AntoninLize/Projet_OrangeLabs/README.md

# Projet_OrangeLabs

Etudiants travaillant sur ce projet :

   * Antonin Lizé
   * Ludovic Diguet

Collaboration avec :

   * Jacques Chodorowski travaillant à OrangeLabs à Lannion (Finistère)
