AntoninLize/Projet_OrangeLabs/Code/Workspace_Realsens_RPLidar/README.md

# Ces programmes ne sont exécutables que dans un Workspace prédéfini

**Pour l'utilisation :**

````
Installation des SDK décrits dans le rapport, intaller les package ROS pour le fonctionnement des composants.

````

````
Les packages sont déja installés et prêt à utilisation sur le NUC

````

````
Dans le dossier source :
 - Le pacckage pour la caméra Realsense  : realsense-ros
 - Le package pour le rplidar : rplidar_ros

````

````
Les commandes à utiliser pour le lancement sont :
Pour la caméra : roslaunch realsense2-camera rs-camera.launch
Pour le rplidar : roslaunch rplidar_ros rplidar.launch

````
