AntoninLize/Projet_OrangeLabs/Code/Arduino/README.md

#Installation de la librairie DualVNH5019MotorShield

**Consignes :**

````
Il suffit d'ouvrir Arduino, d'aller dans l'onglet "Croquis". 

````

````
Cliquez sur "Inclure une Bibliothèque" -> Gérer les bibliothèques

````

````
Dans la fenêtre Gestionnaire de bibliothèque "Filtrez la recherche" en tapant le nom de la bibliothéque.

````

````
Mettez ensuite installer et l'inclusion se fait immédiatement par #include "DualVNH5019MotorShield.h"
en tête du code Arduino

````
