AntoninLize/Projet_OrangeLabs/Rapport/images/station de recharge/Archi 1.png

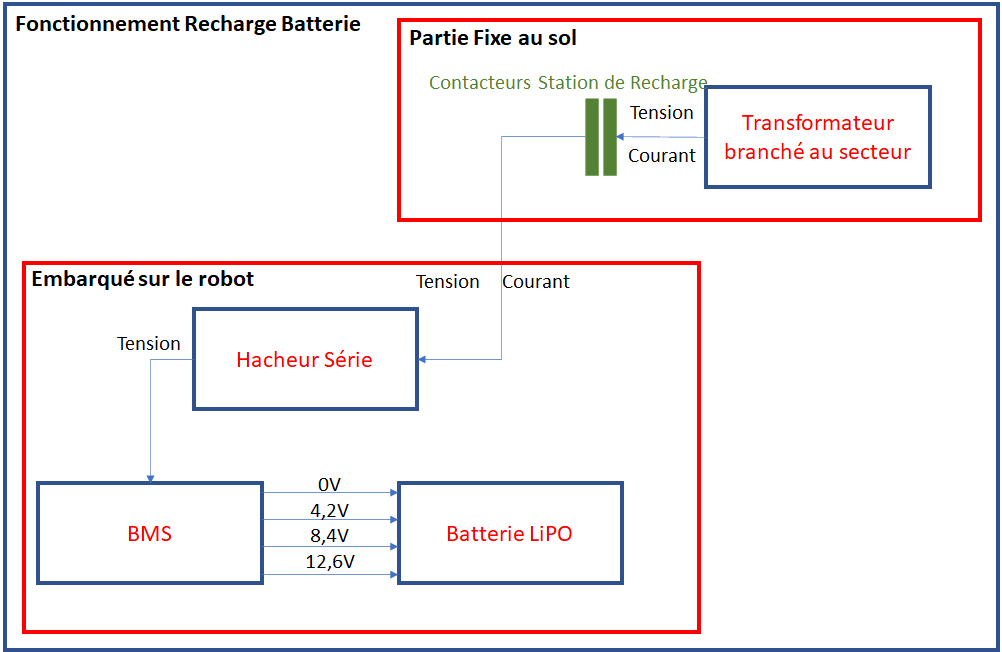
Rapport/images/station de recharge/Archi 1.png
