AntoninLize/Projet_OrangeLabs/CAO/Robot/Support batterie/Couvercle_support_batterie.stl

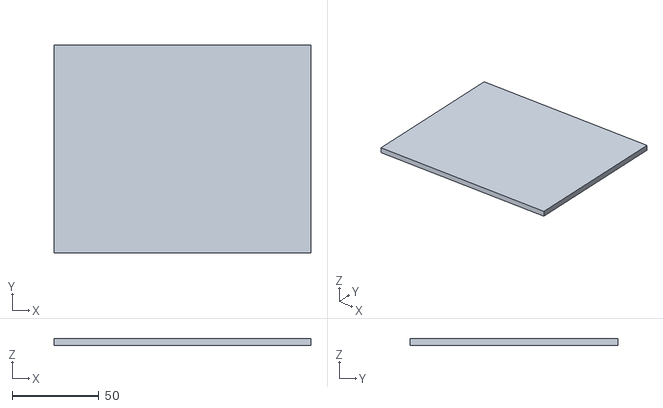
[picture p35: CAD file, 2020-05-09]
CAO/Robot/Support batterie/Couvercle_support_batterie.stl
148.0 x 120.0 x 4.00
