AntoninLize/Projet_OrangeLabs/CAO/Station de recharge/pièce_fixe_station.stl

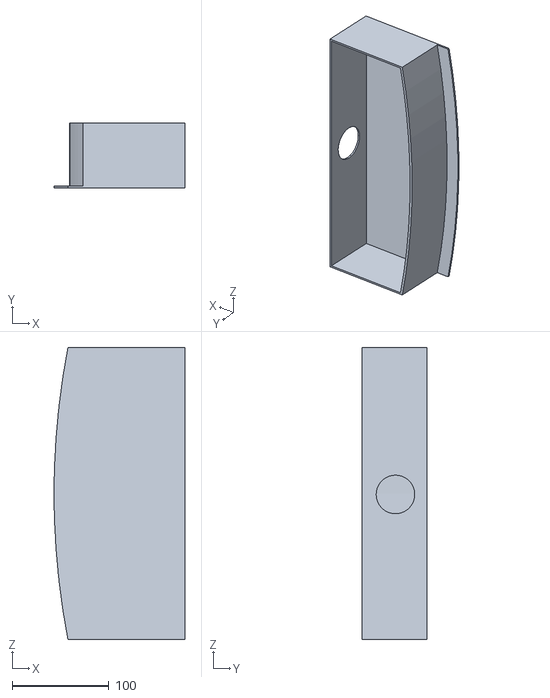
[picture p36: CAD file, 2020-05-09]
CAO/Station de recharge/pièce_fixe_station.stl
135.0 x 67.0 x 301.2
