AntoninLize/Projet_OrangeLabs/CAO/Station de recharge/usinage/pièce centrale.stl

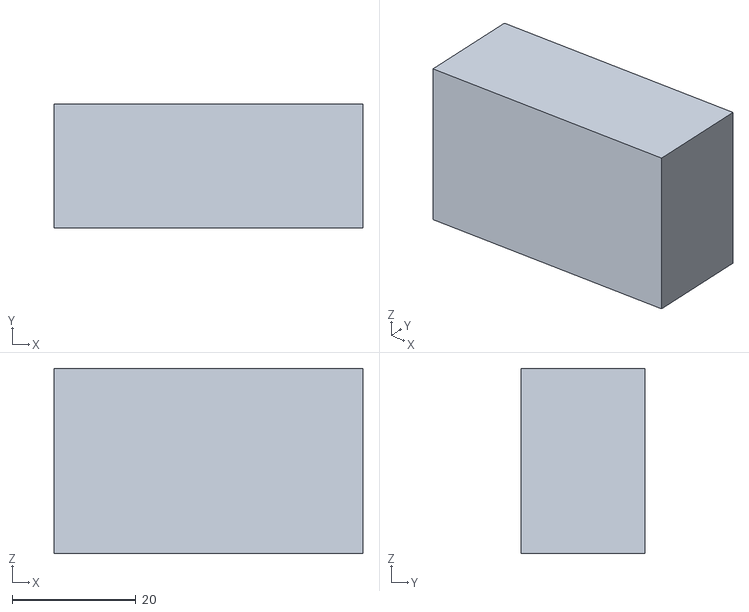
[picture p37: CAD file, 2020-05-09]
CAO/Station de recharge/usinage/pièce centrale.stl
50.0 x 20.0 x 30.0
