AntoninLize/Projet_OrangeLabs/CAO/Robot/Support batterie/Support_batterie.stl

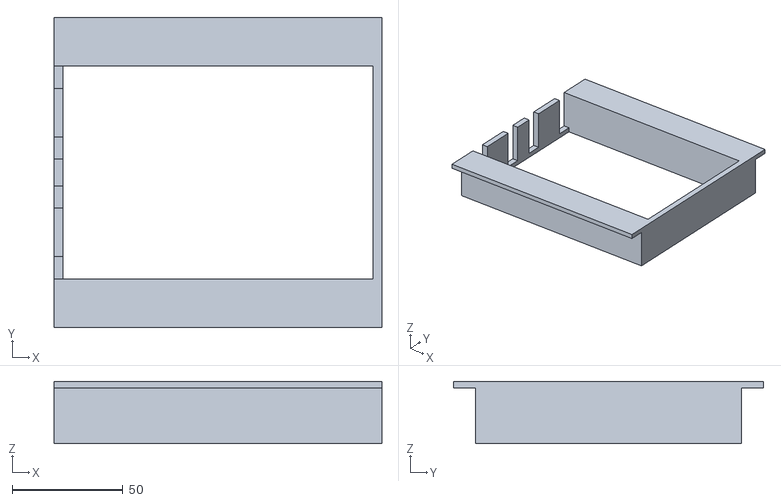
[picture p38: CAD file, 2020-05-09]
CAO/Robot/Support batterie/Support_batterie.stl
148.0 x 140.0 x 28.0
