AntoninLize/Projet_OrangeLabs/CAO/Station de recharge/pièce_mobile_station.stl

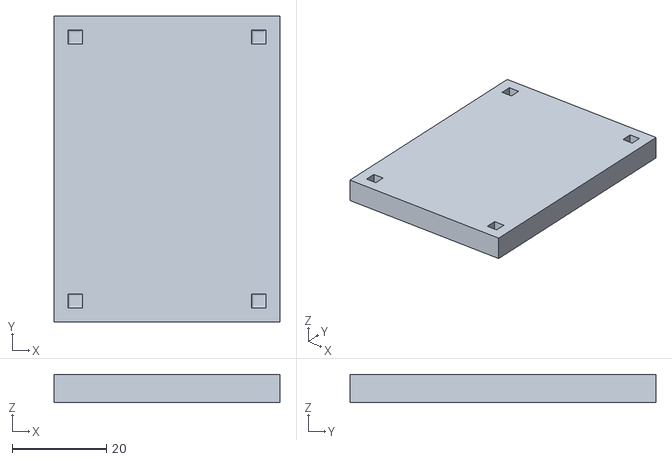
[picture p39: CAD file, 2020-05-09]
CAO/Station de recharge/pièce_mobile_station.stl
48.0 x 65.0 x 6.00
