AntoninLize/Projet_OrangeLabs/CAO/Station de recharge/usinage/pièce_x2.stl

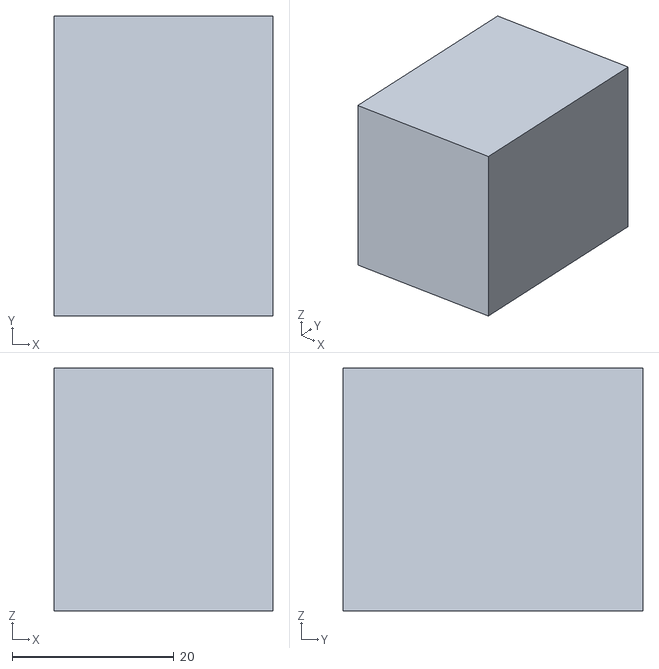
[picture p40: CAD file, 2020-05-09]
CAO/Station de recharge/usinage/pièce_x2.stl
27.0 x 37.0 x 30.0
