AntoninLize/Projet_OrangeLabs/(list of files, cad)

Other CAD files:
CAO/Robot/Chassis/Adaptateur_axes_C.ipt
CAO/Robot/Chassis/Adaptateur_axes_MT.ipt
CAO/Robot/Chassis/Assemblage_chassis_14_11_C.iam
CAO/Robot/Chassis/Assemblage_chassis_14_11_MT.iam
CAO/Robot/Chassis/Chassis.ipt
CAO/Robot/Chassis/Entretoises 50mm.ipt
CAO/Robot/Chassis/Entretoises 80mm.ipt
CAO/Robot/Chassis/Etage 1.ipt
CAO/Robot/Chassis/Etage 2.ipt
CAO/Robot/Chassis/Moteur.ipt
CAO/Robot/Chassis/Moteur_C.ipt
CAO/Robot/Chassis/Moteur_MT.ipt
CAO/Robot/Chassis/OldVersions/Assemblage_chassis_14_11.0005.iam
CAO/Robot/Chassis/OldVersions/Roue_moteur_C.0002.iam
CAO/Robot/Chassis/OldVersions/Roue_moteur_MT.0003.iam
CAO/Robot/Chassis/Roue.ipt
CAO/Robot/Chassis/Roue_Crawler.ipt
CAO/Robot/Chassis/Roue_MonsterTruck.ipt
CAO/Robot/Chassis/Roue_moteur_C.iam
CAO/Robot/Chassis/Roue_moteur_MT.iam
CAO/Robot/Chassis/Support_moteur_C.ipt
CAO/Robot/Chassis/Support_moteur_MT.ipt
CAO/Robot/Etage/Etage.ipt
CAO/Robot/Etage/OldVersions/Etage.0004.ipt
CAO/Robot/Etage/entretoise.ipt
CAO/Robot/Support batterie/Couvercle_support_batterie.ipt
CAO/Robot/Support batterie/OldVersions/Couvercle_support_batterie.0002.ipt
CAO/Robot/Support batterie/OldVersions/Support_batterie.0004.ipt
CAO/Robot/Support batterie/Support_batterie.ipt
CAO/Station de recharge/OldVersions/arc n°1.0004.ipt
CAO/Station de recharge/OldVersions/arc n°2.0004.ipt
CAO/Station de recharge/OldVersions/arc n°3.0003.ipt
CAO/Station de recharge/OldVersions/arc n°4.0003.ipt
CAO/Station de recharge/OldVersions/arc n°5.0002.ipt
CAO/Station de recharge/OldVersions/arc n°6.0001.ipt
CAO/Station de recharge/OldVersions/arc_de_cercle.0002.ipt
CAO/Station de recharge/OldVersions/bloc station.0001.ipt
CAO/Station de recharge/OldVersions/contacteur.0004.ipt
CAO/Station de recharge/OldVersions/couvercle_contacteur.0004.ipt
CAO/Station de recharge/OldVersions/pièce_chassis.0001.ipt
CAO/Station de recharge/OldVersions/pièce_fixe_station.0004.ipt
CAO/Station de recharge/OldVersions/pièce_mobile_station.0006.ipt
CAO/Station de recharge/OldVersions/socle chassis_ressort.0003.ipt
CAO/Station de recharge/OldVersions/visualisation.0002.ipt
CAO/Station de recharge/bloc station.ipt
CAO/Station de recharge/pièce_chassis.ipt
CAO/Station de recharge/pièce_fixe_station.ipt
CAO/Station de recharge/pièce_mobile_station.ipt
CAO/Station de recharge/socle chassis_ressort.ipt
CAO/Station de recharge/usinage/pièce centrale.ipt
CAO/Station de recharge/usinage/pièce1.ipt
CAO/Station de recharge/usinage/pièce_x2.ipt
CAO/Station de recharge/visualisation.ipt
