AntoninLize/Projet_OrangeLabs/Code/Workspace_Realsens_RPLidar/build/install_manifest.txt

/home/orange/catkin_ws/install/_setup_util.py
/home/orange/catkin_ws/install/env.sh
/home/orange/catkin_ws/install/setup.bash
/home/orange/catkin_ws/install/local_setup.bash
/home/orange/catkin_ws/install/setup.sh
/home/orange/catkin_ws/install/local_setup.sh
/home/orange/catkin_ws/install/setup.zsh
/home/orange/catkin_ws/install/local_setup.zsh
/home/orange/catkin_ws/install/.rosinstall
/home/orange/catkin_ws/install/lib/pkgconfig/realsense2_description.pc
/home/orange/catkin_ws/install/share/realsense2_description/cmake/realsense2_descriptionConfig.cmake
/home/orange/catkin_ws/install/share/realsense2_description/cmake/realsense2_descriptionConfig-version.cmake
/home/orange/catkin_ws/install/share/realsense2_description/package.xml
/home/orange/catkin_ws/install/share/realsense2_description/launch/view_multiple_d435_models.launch
/home/orange/catkin_ws/install/share/realsense2_description/launch/view_d415_model.launch
/home/orange/catkin_ws/install/share/realsense2_description/launch/view_r410_model.launch
/home/orange/catkin_ws/install/share/realsense2_description/launch/view_d435_model.launch
/home/orange/catkin_ws/install/share/realsense2_description/launch/view_r430_model.launch
/home/orange/catkin_ws/install/share/realsense2_description/meshes/d415.stl
/home/orange/catkin_ws/install/share/realsense2_description/meshes/d435.dae
/home/orange/catkin_ws/install/share/realsense2_description/rviz/urdf.rviz
/home/orange/catkin_ws/install/share/realsense2_description/urdf/_d435.urdf.xacro
/home/orange/catkin_ws/install/share/realsense2_description/urdf/test_d435_multiple_cameras.urdf.xacro
/home/orange/catkin_ws/install/share/realsense2_description/urdf/_materials.urdf.xacro
/home/orange/catkin_ws/install/share/realsense2_description/urdf/_d415.urdf.xacro
/home/orange/catkin_ws/install/share/realsense2_description/urdf/test_r430_camera.urdf.xacro
/home/orange/catkin_ws/install/share/realsense2_description/urdf/_r430.urdf.xacro
/home/orange/catkin_ws/install/share/realsense2_description/urdf/test_r410_camera.urdf.xacro
/home/orange/catkin_ws/install/share/realsense2_description/urdf/test_d415_camera.urdf.xacro
/home/orange/catkin_ws/install/share/realsense2_description/urdf/_r410.urdf.xacro
/home/orange/catkin_ws/install/share/realsense2_description/urdf/test_d435_camera.urdf.xacro
/home/orange/catkin_ws/install/lib/pkgconfig/rplidar_ros.pc
/home/orange/catkin_ws/install/share/rplidar_ros/cmake/rplidar_rosConfig.cmake
/home/orange/catkin_ws/install/share/rplidar_ros/cmake/rplidar_rosConfig-version.cmake
/home/orange/catkin_ws/install/share/rplidar_ros/package.xml
/home/orange/catkin_ws/install/lib/rplidar_ros/rplidarNode
/home/orange/catkin_ws/install/lib/rplidar_ros/rplidarNodeClient
/home/orange/catkin_ws/install/share/rplidar_ros/launch/test_rplidar.launch
/home/orange/catkin_ws/install/share/rplidar_ros/launch/view_rplidar_s1_tcp.launch
/home/orange/catkin_ws/install/share/rplidar_ros/launch/rplidar_s1.launch
/home/orange/catkin_ws/install/share/rplidar_ros/launch/view_rplidar_s1.launch
/home/orange/catkin_ws/install/share/rplidar_ros/launch/view_rplidar.launch
/home/orange/catkin_ws/install/share/rplidar_ros/launch/rplidar_a3.launch
/home/orange/catkin_ws/install/share/rplidar_ros/launch/rplidar.launch
/home/orange/catkin_ws/install/share/rplidar_ros/launch/rplidar_s1_tcp.launch
/home/orange/catkin_ws/install/share/rplidar_ros/launch/test_rplidar_a3.launch
/home/orange/catkin_ws/install/share/rplidar_ros/launch/view_rplidar_a3.launch
/home/orange/catkin_ws/install/share/rplidar_ros/rviz/rplidar.rviz
/home/orange/catkin_ws/install/share/rplidar_ros/sdk/src/rplidar_driver.cpp
/home/orange/catkin_ws/install/share/rplidar_ros/sdk/src/rplidar_driver_serial.h
/home/orange/catkin_ws/install/share/rplidar_ros/sdk/src/sdkcommon.h
/home/orange/catkin_ws/install/share/rplidar_ros/sdk/src/hal/assert.h
/home/orange/catkin_ws/install/share/rplidar_ros/sdk/src/hal/thread.h
/home/orange/catkin_ws/install/share/rplidar_ros/sdk/src/hal/socket.h
/home/orange/catkin_ws/install/share/rplidar_ros/sdk/src/hal/abs_rxtx.h
/home/orange/catkin_ws/install/share/rplidar_ros/sdk/src/hal/locker.h
/home/orange/catkin_ws/install/share/rplidar_ros/sdk/src/hal/event.h
/home/orange/catkin_ws/install/share/rplidar_ros/sdk/src/hal/byteops.h
/home/orange/catkin_ws/install/share/rplidar_ros/sdk/src/hal/util.h
/home/orange/catkin_ws/install/share/rplidar_ros/sdk/src/hal/types.h
/home/orange/catkin_ws/install/share/rplidar_ros/sdk/src/hal/thread.cpp
/home/orange/catkin_ws/install/share/rplidar_ros/sdk/src/rplidar_driver_impl.h
/home/orange/catkin_ws/install/share/rplidar_ros/sdk/src/rplidar_driver_TCP.h
/home/orange/catkin_ws/install/share/rplidar_ros/sdk/src/arch/macOS/timer.cpp
/home/orange/catkin_ws/install/share/rplidar_ros/sdk/src/arch/macOS/net_socket.cpp
/home/orange/catkin_ws/install/share/rplidar_ros/sdk/src/arch/macOS/net_serial.cpp
/home/orange/catkin_ws/install/share/rplidar_ros/sdk/src/arch/macOS/timer.h
/home/orange/catkin_ws/install/share/rplidar_ros/sdk/src/arch/macOS/arch_macOS.h
/home/orange/catkin_ws/install/share/rplidar_ros/sdk/src/arch/macOS/thread.hpp
/home/orange/catkin_ws/install/share/rplidar_ros/sdk/src/arch/macOS/net_serial.h
/home/orange/catkin_ws/install/share/rplidar_ros/sdk/src/arch/win32/timer.cpp
/home/orange/catkin_ws/install/share/rplidar_ros/sdk/src/arch/win32/net_socket.cpp
/home/orange/catkin_ws/install/share/rplidar_ros/sdk/src/arch/win32/winthread.hpp
/home/orange/catkin_ws/install/share/rplidar_ros/sdk/src/arch/win32/net_serial.cpp
/home/orange/catkin_ws/install/share/rplidar_ros/sdk/src/arch/win32/timer.h
/home/orange/catkin_ws/install/share/rplidar_ros/sdk/src/arch/win32/net_serial.h
/home/orange/catkin_ws/install/share/rplidar_ros/sdk/src/arch/win32/arch_win32.h
/home/orange/catkin_ws/install/share/rplidar_ros/sdk/src/arch/linux/timer.cpp
/home/orange/catkin_ws/install/share/rplidar_ros/sdk/src/arch/linux/net_socket.cpp
/home/orange/catkin_ws/install/share/rplidar_ros/sdk/src/arch/linux/net_serial.cpp
/home/orange/catkin_ws/install/share/rplidar_ros/sdk/src/arch/linux/arch_linux.h
/home/orange/catkin_ws/install/share/rplidar_ros/sdk/src/arch/linux/timer.h
/home/orange/catkin_ws/install/share/rplidar_ros/sdk/src/arch/linux/thread.hpp
/home/orange/catkin_ws/install/share/rplidar_ros/sdk/src/arch/linux/net_serial.h
/home/orange/catkin_ws/install/share/rplidar_ros/sdk/README.txt
/home/orange/catkin_ws/install/share/rplidar_ros/sdk/include/rplidar_driver.h
/home/orange/catkin_ws/install/share/rplidar_ros/sdk/include/rptypes.h
/home/orange/catkin_ws/install/share/rplidar_ros/sdk/include/rplidar_cmd.h
/home/orange/catkin_ws/install/share/rplidar_ros/sdk/include/rplidar.h
/home/orange/catkin_ws/install/share/rplidar_ros/sdk/include/rplidar_protocol.h
/home/orange/catkin_ws/install/share/realsense2_camera/msg/IMUInfo.msg
/home/orange/catkin_ws/install/share/realsense2_camera/msg/Extrinsics.msg
/home/orange/catkin_ws/install/share/realsense2_camera/cmake/realsense2_camera-msg-paths.cmake
/home/orange/catkin_ws/install/include/realsense2_camera/Extrinsics.h
/home/orange/catkin_ws/install/include/realsense2_camera/IMUInfo.h
/home/orange/catkin_ws/install/share/roseus/ros/realsense2_camera/msg/IMUInfo.l
/home/orange/catkin_ws/install/share/roseus/ros/realsense2_camera/msg/Extrinsics.l
/home/orange/catkin_ws/install/share/roseus/ros/realsense2_camera/manifest.l
/home/orange/catkin_ws/install/share/common-lisp/ros/realsense2_camera/msg/_package_IMUInfo.lisp
/home/orange/catkin_ws/install/share/common-lisp/ros/realsense2_camera/msg/_package_Extrinsics.lisp
/home/orange/catkin_ws/install/share/common-lisp/ros/realsense2_camera/msg/IMUInfo.lisp
/home/orange/catkin_ws/install/share/common-lisp/ros/realsense2_camera/msg/realsense2_camera-msg.asd
/home/orange/catkin_ws/install/share/common-lisp/ros/realsense2_camera/msg/Extrinsics.lisp
/home/orange/catkin_ws/install/share/common-lisp/ros/realsense2_camera/msg/_package.lisp
/home/orange/catkin_ws/install/share/gennodejs/ros/realsense2_camera/_index.js
/home/orange/catkin_ws/install/share/gennodejs/ros/realsense2_camera/msg/_index.js
/home/orange/catkin_ws/install/share/gennodejs/ros/realsense2_camera/msg/IMUInfo.js
/home/orange/catkin_ws/install/share/gennodejs/ros/realsense2_camera/msg/Extrinsics.js
/home/orange/catkin_ws/install/lib/python2.7/dist-packages/realsense2_camera/__init__.py
/home/orange/catkin_ws/install/lib/python2.7/dist-packages/realsense2_camera/msg/__init__.py
/home/orange/catkin_ws/install/lib/python2.7/dist-packages/realsense2_camera/msg/_IMUInfo.py
/home/orange/catkin_ws/install/lib/python2.7/dist-packages/realsense2_camera/msg/_Extrinsics.pyc
/home/orange/catkin_ws/install/lib/python2.7/dist-packages/realsense2_camera/msg/_IMUInfo.pyc
/home/orange/catkin_ws/install/lib/python2.7/dist-packages/realsense2_camera/msg/_Extrinsics.py
/home/orange/catkin_ws/install/lib/python2.7/dist-packages/realsense2_camera/msg/__init__.pyc
/home/orange/catkin_ws/install/lib/python2.7/dist-packages/realsense2_camera/__init__.pyc
/home/orange/catkin_ws/install/lib/pkgconfig/realsense2_camera.pc
/home/orange/catkin_ws/install/share/realsense2_camera/cmake/realsense2_camera-msg-extras.cmake
/home/orange/catkin_ws/install/share/realsense2_camera/cmake/realsense2_cameraConfig.cmake
/home/orange/catkin_ws/install/share/realsense2_camera/cmake/realsense2_cameraConfig-version.cmake
/home/orange/catkin_ws/install/share/realsense2_camera/package.xml
/home/orange/catkin_ws/install/lib/librealsense2_camera.so
/home/orange/catkin_ws/install/include/realsense2_camera/t265_realsense_node.h
/home/orange/catkin_ws/install/include/realsense2_camera/base_realsense_node.h
/home/orange/catkin_ws/install/include/realsense2_camera/realsense_node_factory.h
/home/orange/catkin_ws/install/include/realsense2_camera/constants.h
/home/orange/catkin_ws/install/share/realsense2_camera/launch/demo_pointcloud.launch
/home/orange/catkin_ws/install/share/realsense2_camera/launch/opensource_tracking.launch
/home/orange/catkin_ws/install/share/realsense2_camera/launch/rs_from_file.launch
/home/orange/catkin_ws/install/share/realsense2_camera/launch/demo_t265.launch
/home/orange/catkin_ws/install/share/realsense2_camera/launch/rs_t265.launch
/home/orange/catkin_ws/install/share/realsense2_camera/launch/rs_d400_and_t265.launch
/home/orange/catkin_ws/install/share/realsense2_camera/launch/rs_aligned_depth.launch
/home/orange/catkin_ws/install/share/realsense2_camera/launch/rs_camera.launch
/home/orange/catkin_ws/install/share/realsense2_camera/launch/includes/nodelet.launch.xml
/home/orange/catkin_ws/install/share/realsense2_camera/launch/rs_d435_camera_with_model.launch
/home/orange/catkin_ws/install/share/realsense2_camera/launch/rs_rtabmap.launch
/home/orange/catkin_ws/install/share/realsense2_camera/launch/rs_rgbd.launch
/home/orange/catkin_ws/install/share/realsense2_camera/launch/rs_multiple_devices.launch
/home/orange/catkin_ws/install/share/realsense2_camera/rviz/t265.rviz
/home/orange/catkin_ws/install/share/realsense2_camera/rviz/pointcloud.rviz
/home/orange/catkin_ws/install/share/realsense2_camera/nodelet_plugins.xml
